dl7mo-ham/ESP32-Sound-for-Piko-35040/hardware/gehaeuse-c3/Gehaeuse3D_Vorschau.html

# Gehäuse Sound Mini C3

Entwurf 1. Unterteil und Deckel für den ESP32-C3 Pro Mini mit dem umgedrehten MAX98357A auf der Versorgungsreihe (dein Aufbau vom Foto 12.11.). Die Bauteilseite des ESP liegt oben, damit BOOT, RST und LED vom Deckel aus erreichbar sind. Gleiches Prinzip wie beim S3-Gehäuse.

Außen30,9 × 24,4

Höhe17,8 mm

Modul23,4 × 19,3

Ziehen = drehen · Mausrad/zwei Finger = zoomen · rechte Maustaste = schieben

Zustand Zu Deckel ab Explosion

Ansicht Schräg USB-Seite Lautsprecher-Seite Kabel-Seite Oben Unten

Zeigen Modul Deckel Gehäuse durchsichtig

## Öffnungen

Wo | Wofür | Größe
Stirnseite USB | USB-C zum Flashen, Kerbe oben offen, der Deckel schließt sie | 12,8 × 6,7
Stirnseite Antenne | Kabelschlitz Port A (5V, GND, IO20, IO21 zum Empfänger) | 7,2 × 2,9
Stirnseite Antenne | Kabelschlitz Port B (IO5, IO6) | 3,4 × 2,9
Längsseite | Lautsprecher-Stecker JST-PH 2-polig, von außen einstecken | 7,2 × 4,9
Deckel | BOOT = WLAN-Taste, Führungsrohr, mit Zahnstocher drücken | Ø 2,1
Deckel | RST, Führungsrohr | Ø 2,1
Deckel | Lichtrohr über der LED (IO8) | Ø 2,3

## Annahmen, bitte prüfen

- Maße des C3 Pro Mini aus dem Produktfoto geschätzt: 23,4 × 17,8 mm, USB-C ragt 1,5 mm über. Bitte mit dem Messschieber nachmessen.
- BOOT und RST sitzen ca. 8,9 mm von der USB-Kante, BOOT auf der Seite der IO-Reihe (IO5 … IO21). LED-Lage nur geschätzt, das Lichtrohr kann ich verschieben.
- MAX-Klon 17,8 × 19,3 mm, 2,5 mm Abstand (Kunststoff der Stiftleiste), ragt 1,5 mm über die IO-Reihe hinaus.
- Lautsprecher: JST-PH 2-polig liegend auf der Außenseite des MAX, Stecker zeigt zur IO-Seite. Wenn du die Lautsprecherkabel direkt anlötest, reicht der Schlitz auch als Kabeldurchführung.
- Kabel: Der MAX deckt die Rückseite ab, deshalb sind Port A und Port B oben auf der Bauteilseite angelötet und laufen am Rand entlang zur Antennen-Stirnseite.
- Halt: zwei Stützen im Boden (unter MAX und unter dem ESP-Ende), zwei Niederhalter am Deckel (auf USB-Buchse und Keramikantenne). Deckel klemmt mit Lippe und zwei Rastnasen (TOL 0,15).

## Drucken und Montieren

- Material PLA oder PETG, 0,2 mm Schicht (für die feine Schrift 0,12 mm).
- Unterteil mit dem Boden aufs Bett, Deckel mit der Oberseite aufs Bett (STL ist schon gedreht). Keine Stützen nötig.
- Einbauen: Modul mit der ESP-Seite nach oben einlegen, USB-C in die Kerbe, Kabel in die Schlitze A und B legen, Deckel aufdrücken.
- Lautsprecher von außen einstecken.
- Im Modell: 2 Laschen mit 2,4-mm-Loch (M2 oder Kabelbinder) oder doppelseitiges Klebeband.
- Wand, Boden und Deckel je 1,6 mm.

## Dateien

- Gehaeuse_Unterteil.stl / .step
- Gehaeuse_Deckel.stl / .step
- gehaeuse.py (Quelle, CadQuery, alle Maße als Parameter oben in der Datei)

STEP lässt sich in Fusion 360 oder FreeCAD öffnen. Kollisionsprüfung Modul gegen Gehäuse: 0 mm³.
