dl7mo-ham/ESP32-Sound-for-Piko-35040/hardware/gehaeuse-c3/Gehaeuse_Deckel.step

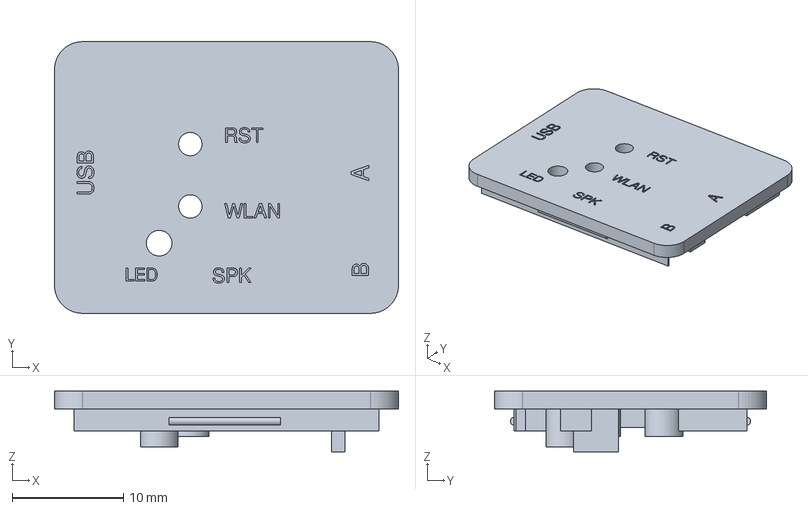
[picture p13: CAD file, 2026-11-13]
hardware/gehaeuse-c3/Gehaeuse_Deckel.step
30.9 x 24.4 x 5.45 mm
