dl7mo-ham/ESP32-Sound-for-Piko-35040/hardware/gehaeuse-c3/Gehaeuse_Unterteil.step

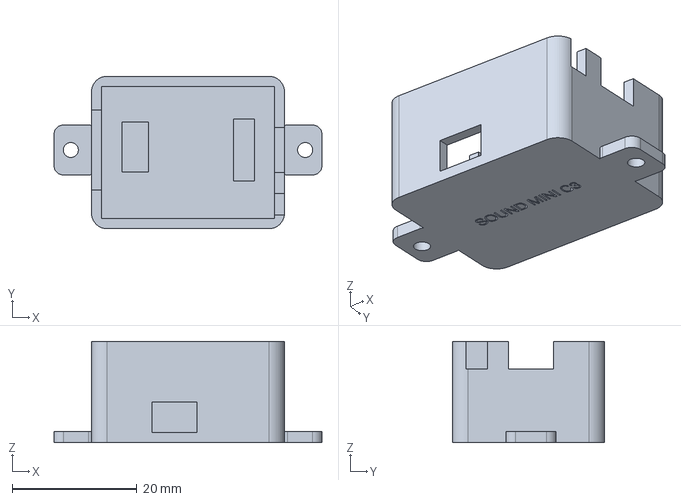
[picture p14: CAD file, 2026-11-13]
hardware/gehaeuse-c3/Gehaeuse_Unterteil.step
42.9 x 24.4 x 16.2 mm
