dl7mo-ham/ESP32-Sound-for-Piko-35040/(list of files, cad)

Other CAD files:
hardware/gehaeuse-c3/Gehaeuse_Deckel.stl
hardware/gehaeuse-c3/Gehaeuse_Unterteil.stl
