dl7mo-ham/ESP32-Sound-for-Piko-35040/docs/hardware-bilder/aufbau_S3.png

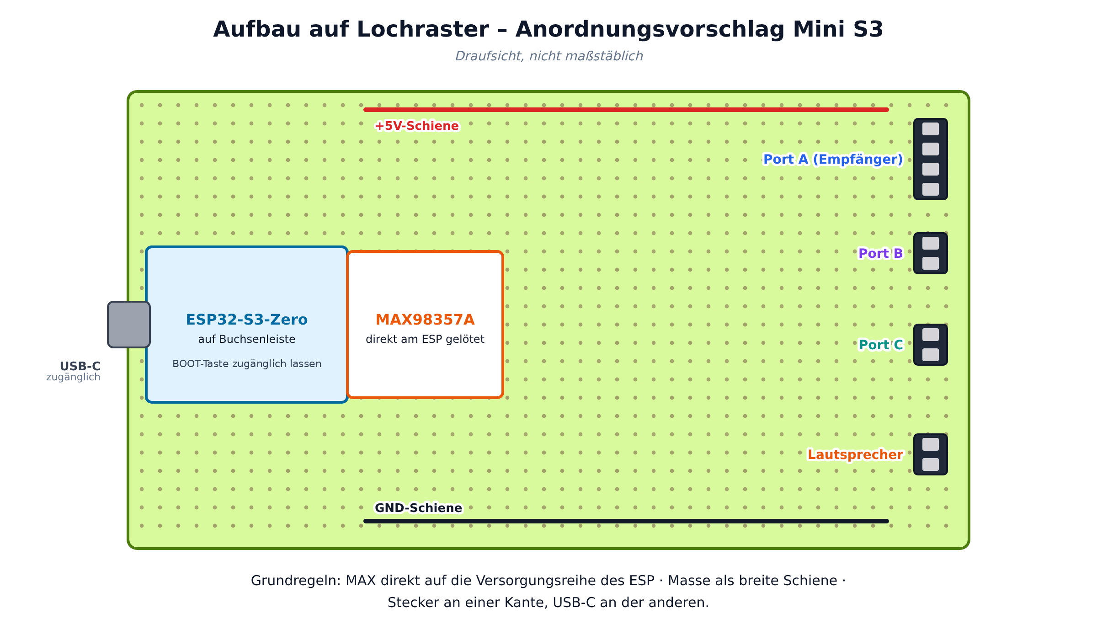
docs/hardware-bilder/aufbau_S3.png
