dl7mo-ham/ESP32-Sound-for-Piko-35040/firmware/ESP32_Sound_Mini_S3/WebServerManager.h

// WebServerManager.h  –  ESP32-RC-Sound
#pragma once
#include <WiFi.h>
#include <WebServer.h>

class WebServerManager {
public:
  // begin() registriert nur die Routen und merkt sich SSID/Passwort - wird
  // IMMER in setup() aufgerufen (unabhaengig von der BOOT-Taste),
  // damit WLAN auch nachtraeglich gestartet werden kann. Das tatsaechliche
  // Ein-/Ausschalten von AP-Funk + Webserver-Socket uebernehmen
  // enableAP()/disableAP() - aufrufbar sowohl beim Booten (falls die BOOT-
  // Taste nach dem Start gedrueckt wurde) als auch spaeter zur Laufzeit (manueller
  // Schalter im Web/Lua-Menue oder automatisch bei RC-Signalverlust, siehe
  // wifiFailsafeCheck() in ESP32-RC-Sound.ino). Public, da direkt aus dem
  // .ino aufgerufen.
  static void begin(const char* apSsid, const char* apPassword);
  static void enableAP();
  static void disableAP();
  static bool isApActive();
  // v7.16: true, solange seit der letzten SD-Schreibaktivitaet (Sound-
  // Upload/-Loeschen) noch keine SD_SAVE_COOLDOWN_MS vergangen sind - siehe
  // markSdActivity() und die Aufrufstelle in loop() (ESP32-RC-Sound.ino).
  // Grund: ohne Stuetzkondensator kann ein sofortiger, blockierender
  // NVS-Flash-Schreibvorgang direkt nach einem SD-Schreibvorgang (Upload)
  // die Spannungsversorgung kurzzeitig so weit einbrechen lassen, dass ein
  // Brownout-Reset/Reset-Loop entsteht (in der Praxis bestaetigt).
  static bool sdActivityCooldownActive();
  static void Webpage();

private:
  static WebServer     server;
  static int           Menu;
  static String        valueString;
  static unsigned long lastSdActivityMs;
  // Von jeder SD-Schreiboperation (Upload-Ende, Sound-/Backup-Loeschen)
  // aufgerufen - startet/verlaengert die Cooldown-Zeit fuer
  // sdActivityCooldownActive().
  static void      markSdActivity();
  static void      handleRequest();
  static void      handleSport();
  static void      handleApiConfig();
  static void      handleApiConfigPost();
  static void      handleApiDebug();
  static void      handleApiSound();
  static String    buildConfigJson();
  // Sound-WAV-Dateien per WLAN direkt auf die SD-Karte hochladen
  // (multipart/form-data, siehe Kommentare in WebServerManager.cpp).
  static void      handleApiSoundUpload();
  static void      handleApiSoundUploadData();
  // Datei-Verwaltung - Status aller Sound-Dateien abfragen, gezielt eine
  // Sound-Datei wieder loeschen (siehe Kommentare
  // in WebServerManager.cpp).
  static void      handleApiSoundFiles();
  static void      handleApiSoundDelete();
  // Firmware-Update direkt per WLAN (OTA) - .bin-Datei per
  // multipart/form-data hochladen, ueber die Arduino-"Update"-Bibliothek
  // ins jeweils inaktive OTA-Flash-Segment schreiben, dann neu starten
  // (siehe Kommentare in WebServerManager.cpp). Braucht eine OTA-faehige
  // Partitionstabelle - siehe platformio.ini.
  // Manueller WLAN-Schalter im Web-Tab "WiFi" (entspricht Lua-Feld 174) -
  // schaltet enableAP()/disableAP() sofort, ohne Neustart und ohne die
  // Konfiguration zu aendern (siehe Kommentare in WebServerManager.cpp).
  static void      handleApiWifiEnable();
  static String    urlDecode(const String& s);
};
