dl7mo-ham/ESP32-Sound-for-Piko-35040/(commit log)

2026-10-13 Code aus ESP32-RC-Sound v7.19 (Branch crsf-bibliothek, 19ce5e0) unveraendert uebernommen
    Claude-Session: https://claude.ai/code/session_019qxJdecKTZsNLcfvg82bXN
2026-10-13 Auf CRSF, Motor + 4 Sounds und ESP32-S3 kuerzen
    - SBUS, PWM/Pin-Eingaenge, Hott und Hardware-Varianten V1/V2/V3 entfernt
    - Sound-Slots von 24 auf 4 reduziert (plus Motor), CRSF-Menue neu nummeriert
    - pins.h mit vorlaeufiger S3-Belegung, Port A = Serial2, Port B = Serial1
    - I2S-MCLK nicht mehr auf GPIO0 (S3-Strapping-Pin)
    - Eigener NVS-Namespace "soundmini", Web-UI entsprechend verschlankt
    - CRSF_ESP32 v1.0.0 als Kopie, Include ohne src/-Praefix
    - lib_deps fuer EspSoftwareSerial und TinyGPSPlus
    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
2026-10-13 CI: fertige Firmware als Download bereitstellen
    Fuegt Bootloader, Partitionstabelle, boot_app0 und Firmware zu einer
    Datei zusammen (Flashen ab 0x0) und laedt sie zusammen mit firmware.bin
    (fuer OTA ueber die Web-UI) als Artefakt hoch.
    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
2026-10-13 Sound-Speicher Flash/SD/Auto (Schritt 4)
    - Neues Modul sound_store: mountet LittleFS (Partition "spiffs" aus
    default.csv) und SD, waehlt nach Einstellung Auto/Flash/SD den
    aktiven Speicher; Auto = SD, wenn eine Karte steckt
    - Wiedergabe, Upload, Loeschen und Dateistatus laufen ueber soundFS()
    - Konfigurations-Backups bleiben auf der SD-Karte, Fehler "no_sd" ohne Karte
    - Einstellung in NVS (sndstor), Web-UI (Einstellungen) und Lua-Menue
    (Einstellungen > Sound-Speicher, Feld 50; Geraetename jetzt Feld 51)
    - README: Sounds per Web-UI oder pio run -t uploadfs ins Flash
    Claude-Session: https://claude.ai/code/session_019qx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
2026-10-18 MAX98357A direkt auf die Versorgungsreihe des ESP
    Pinbelegung so umgestellt, dass der MAX98357A ohne Kabel auf
    5V, GND, 3V3 und die folgenden vier GPIOs geloetet wird
    (VIN-5V, GND-GND, SD-3V3, GAIN, DIN, BCLK, LRC). Neues Bild
    max_direkt, Dokument und README angepasst.
    pins.h: I2S auf 2/3/4, GAIN 1, Port B 7/8, WLAN 9, GPS 44/43.
    main.cpp: GAIN-Pin als Eingang ohne Pull-up (9 dB).
    Claude-Session: https://claude.ai/code/session_01Ty5RYkDwYVKc2svXrgQ3BJ
2026-10-18 Bauplan vereinfacht: ohne Elko, ohne SD-Karte, SD-Pin des MAX offen
    3V3 des ESP bleibt frei (SD-Pin des MAX nicht geloetet, das Breakout
    schaltet den Verstaerker selbst ein). Port B und Port C nur noch als
    RX/TX beschrieben, S.Port-Bild entfernt.
    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
2026-10-21 v0.02: Port C als Hardware-UART, Rolle je Port waehlbar
    Port B (UART1) und Port C (UART0, IO44/43) waehlen ihre Rolle jetzt beide
    in Web-UI und Lua: Aus, CRSF, S.Port, Raw oder GPS, je mit Baudrate.
    GPS laeuft ueber Hardware-UART statt SoftwareSerial (Bibliothek
    entfaellt). Jede Rolle nur auf einem Port; doppelt gewaehlt bleibt Port C
    aus (Hinweis in der Web-UI). Lua: Feld 45 = Port C Modus, neues Feld 52 =
    Port C Baudrate. NVS: alter Schluessel pcgps wird uebernommen.
    Claude-Session: https://claude.ai/code/session_01DCSfbUcxwowukecTuzyW8z
2026-10-21 v0.03: RC_Common 1.0.0 als gemeinsame Basis, Core 3.0.7
    - PlatformIO ueber pioarduino 51.03.07 = Arduino-ESP32-Core 3.0.7
    - src/RC_Common/ (identische Kopie wie in Multiswitch und Soundmodul V7)
    ersetzt CRSF_ESP32, sport_lipo, gps_speed und port_function
    - Port B/C: Rollen aus RC_Common (Aus, CRSF, S.Port, GPS, Raw), CRSF als
    Router der Modulkette; alte Werte werden einmalig umgerechnet
    - WLAN, Modul-Adresse, Port B/C unter den gemeinsamen NVS-Schluesseln
    - Lua-Menue als Tabelle (buildLuaMenu), Feld-IDs unveraendert
    - Status-LED auf der RGB-LED des S3-Zero (GPIO 21)
    - WLAN-Failsafe, OTA-Upload und /rc_common.js aus RC_Common
    - Web-API: portb_role/portc_role, alte Sicherungen werden umger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
    [WebServerManager.cpp, WebServerManager.h, config.cpp, config.h, main.cpp, pins.h]
2026-10-21 GPS-Baudrate "Auto" (RC_Common 1.1.0)
    - RC_Common 1.1.0: gps_autobaud sucht die Baudrate des GPS
    (9600/115200/38400/57600/19200), stellt es auf 115200 Baud und 10 Hz um
    (CASIC/ATGM336H, u-blox M8/M9/M10) und sucht nach 3 s ohne gueltige
    NMEA-Saetze neu. Klappt das Umstellen nicht, bleibt die gefundene Rate.
    - Baudratenliste mit "Auto" als Eintrag 0 (Lua und Web), Vorgabe fuer
    die Rolle GPS; andere Rollen nehmen bei "Auto" ihre Protokoll-Baudrate.
    Alte GPS-Baudraten werden bei der NVS-Uebernahme auf "Auto" gesetzt.
    - /rc_common.js: rcFillBaud() fuer die Baudraten-Auswahl
    - Host-Tests mit simuliertem GPS (tests/test_gps.cpp)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
2026-10-22 v0.04: SD-Option entfernt, Sounds nur im Flash
    Das Mini hat keine SD-Karte: Auswahl Auto/Flash/SD in Web-UI, Lua-Menue
    (Feld 50 nur noch Anzeige) und API entfernt, SD-Pins frei.
2026-10-26 v0.05: WLAN per BOOT-Taste statt WLAN-Bruecke an GPIO9
    Ist "WLAN dauerhaft an" aus, wartet die Firmware nach dem Start 3 s
    auf die BOOT-Taste (GPIO0, LED blinkt blau) und schaltet dann das WLAN
    ein. GPIO9 und der Jumper entfallen. README, Hardware-Bauplan (Text,
    Tabellen, Bilder) und Projektbeschreibung auf Stand v0.05.
    Claude-Session: https://claude.ai/code/session_01JXJ2Td9EZV44BujZPFUYxn
2026-10-27 Firmware als Arduino-Skizze (ESP32_Sound_Mini_S3.ino)
    - firmware/src/ -> firmware/ESP32_Sound_Mini_S3/, main.cpp wird zur .ino,
    RC_Common liegt unter src/RC_Common/ (wie beim Multiswitch)
    - platformio.ini zeigt per src_dir auf den Skizzen-Ordner, pio bleibt nutzbar
    - CI baut mit arduino-cli (esp32@3.0.7) und zusaetzlich mit PlatformIO
    - README: Arduino-IDE-Einstellungen
2026-10-27 CI: TinyGPSPlus 1.0.3 aus dem Arduino-Bibliotheksindex
2026-10-27 v0.06: Speicherbelegung im Web-UI und Lua-Menue anzeigen
    Neuer Baustein mem_info.cpp/.h liest Firmware-Groesse/App-Partition,
    belegten Platz im Flash-Dateisystem (Sounds + Backups), freien RAM
    (aktuell und minimal) und freien PSRAM.
    - Web: Tab Debug, Karte "Speicherbelegung" mit Balken (ueber /api/debug "mem")
    - Lua: Ordner "Speicher" (Felder 53-57, nur Anzeige)
    - README: Abschnitt "Speicherbelegung anzeigen", Versionstabelle
    Claude-Session: https://claude.ai/code/session_0118D4qtzFxgYKSkNcby3gtc
2026-11-01 Verdrahtung mit Piko 35040 und LM2596 skizziert
2026-11-02 IO5 und IO6 als Reedkontakte statt CRSF nutzbar
2026-11-02 Arduino-Loop und FreeRTOS-Tasks dokumentiert
2026-11-06 fix: Lautstärkeeinstellung in Web-UI und Firmware korrigiert
    [ESP32_Sound_Mini_S3.ino, WebServerManager.cpp, XT_I2S_Audio.cpp]
2026-11-06 docs: Drehzahl- und Tonhöhenvariation des Motorsounds in audio-ablauf.md dokumentiert
2026-11-06 Umbau der Reed-Trigger-Logik auf IO6 = Motorsound (Toggle) und IO5 = Sound1/Sound2 (kurz/lang)
2026-11-08 Reed-Trigger: langer IO6-Impuls toggelt die LED, kurzer weiterhin den Motorsound
2026-11-08 feat: Flammen-Effekt fuer die Status-LED im Reed-Modus
2026-11-08 docs: Kurzbeschreibung des Soundmoduls im README ergaenzt
2026-11-08 Web-UI: Reed-Texte fuer IO5/IO6 verstaendlicher formulieren
    - "toggeln" durch konkrete Beschreibung ersetzt (Motorsound bzw. LED ein-/ausschalten)
    - IO5 vor IO6 einsortiert
    - "sound1"/"sound2" als "Sound 1"/"Sound 2" angezeigt
2026-11-09 Reed-Trigger: Entprellzeit, Lang-Puls und Retrigger per Web-UI einstellbar
2026-11-10 Autor: PiperPilot statt vollem Namen (#17)
    Voller Name in Code-Kommentaren und DOCX (Autor-Feld und Text)
    durch PiperPilot ersetzt.
    Claude-Session: https://claude.ai/code/session_0118D4qsuskq7CY6JdgR6nyy
2026-11-12 v0.09: ESP32-C3 Pro Mini als zweites Board
    pins.h waehlt die Pins nach dem Board (CONFIG_IDF_TARGET_ESP32C3).
    C3: MAX umgedreht auf IO4..IO1, Port A UART0 IO20/21, Port B IO5/6,
    kein Port C, WLAN-Taste IO9, Audio-Tasks ohne festen Kern.
    CI baut S3 und C3 (Arduino-Matrix und PlatformIO env c3).
    Claude-Session: https://claude.ai/code/session_0118D4qqsoBXd65H3PaPuVF2
2026-11-13 Gehäuse für das Sound Mini C3 (ESP32-C3 Pro Mini)
    3D-Druck-Gehäuse (Unterteil + Deckel, STL/STEP, CadQuery-Quelle, 3D-Vorschau)
    in hardware/gehaeuse-c3/, README-Abschnitt im C3-Teil.
    Claude-Session: https://claude.ai/code/session_0118D4qtcprpBMd5sENUsqFM
    [Gehaeuse_Deckel.step, Gehaeuse_Deckel.stl, Gehaeuse_Unterteil.step, Gehaeuse_Unterteil.stl]
2026-11-13 Lua: Kanal-Felder bleiben Zahlenfelder (Kanalwahl ohne Menue-Verlassen)
    Bei Quelle Aus/Dauer wurde 'Kanal Nr' zum Info-Feld 'Deaktiviert'. Das
    ELRS-Lua-Skript laedt nach einer Aenderung der Quelle nur Zahlen- und
    Auswahlfelder neu, daher liess sich der Kanal nach dem Umstellen (z. B.
    auf EK) erst nach Verlassen des Menues aendern. Jetzt bleibt das Feld
    ein Zahlenfeld und ist bei Aus/Dauer gesperrt (min = max).
    Claude-Session: https://claude.ai/code/session_0118D4qtmncHargSS3A41WBD
2026-11-13 Revise README to specify ESP32-S3-Zero and control method
    Updated the description to reflect the use of ESP32-S3-Zero and Reed-Trigger.
